Giraut/mnt_reform_bottom_spacer/mnt_reform_bottom_spacer.FCStd

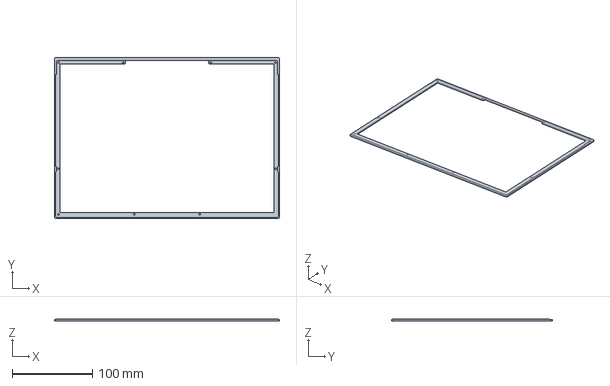
[picture p10: CAD file, 2025-06-11]
mnt_reform_bottom_spacer.FCStd
280.0 x 200.0 x 2.95 mm
