Giraut/mnt_reform_bottom_spacer/mnt_reform_bottom_spacer-no_reinforcements.step

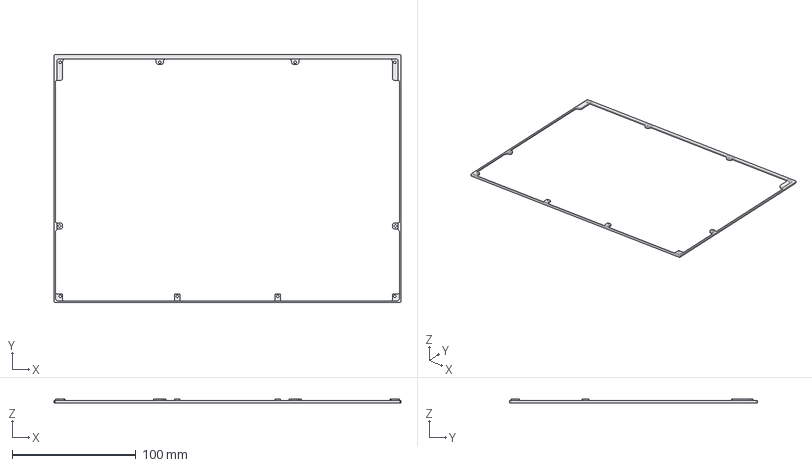
[picture p11: CAD file, 2025-06-11]
mnt_reform_bottom_spacer-no_reinforcements.step
280.0 x 200.0 x 2.95 mm
