Giraut/mnt_reform_bottom_spacer/(list of files, cad)

Other CAD files:
mnt_reform_bottom_spacer-with_reinforcements.step
